mostafa-ehab22/Robotic-Arm/images/mechanical_model.png

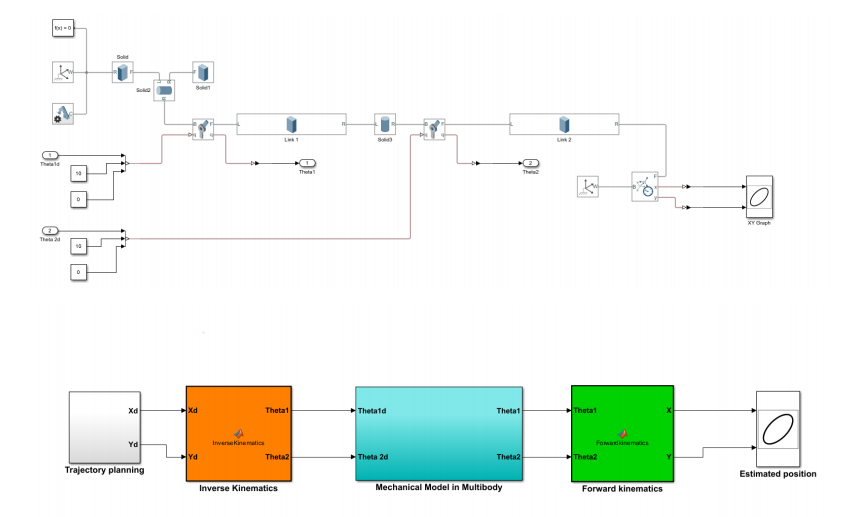
images/mechanical_model.png
