mostafa-ehab22/Robotic-Arm/images/contours_results.png

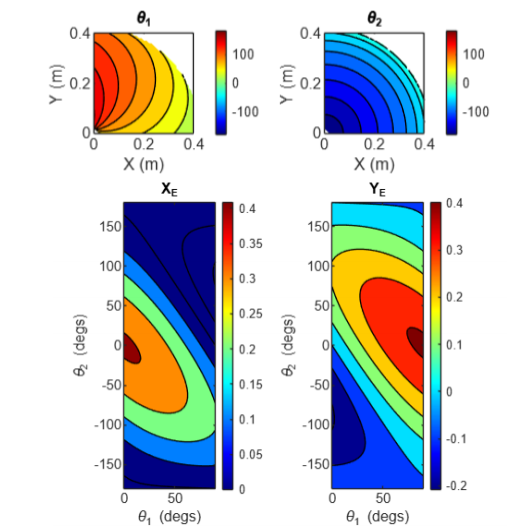
images/contours_results.png
